Theodemo/clavier_midi/Rapport_VCO.pdf

# Rapport de projet

## Électronique Analogique

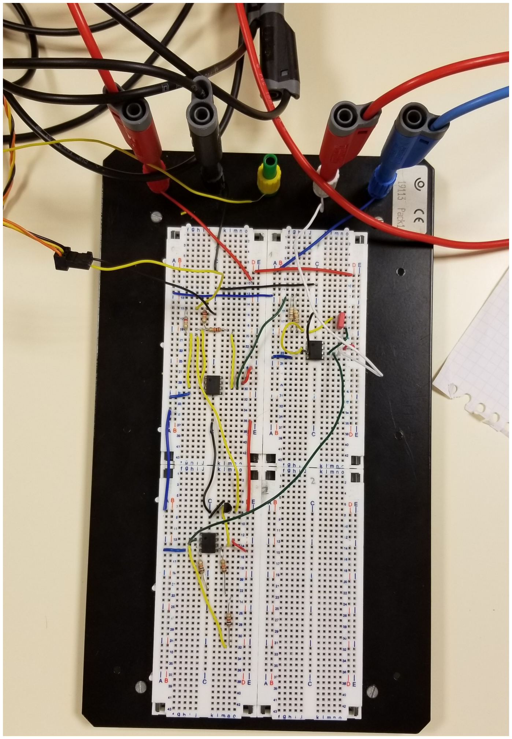
[picture p25: figure]

Théo de Morais & Maël CREAC’H – S1A A - 2020

## Table des matières

## Les résultats obtenus par simulation :

AOP numéro 1

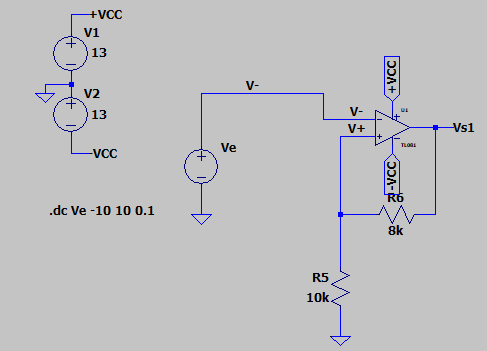
[picture p26: figure]

Nos expressions sont :
V
= Vs3

V

+ =

R5∗VS 1
R5+R6

Détermination des seuils :

VS 1=VSAT + quand VS 3<

R5∗V S1
R5+R6

VS 1=VSAT - quand VS 3>

R5∗V S1
R5+R6

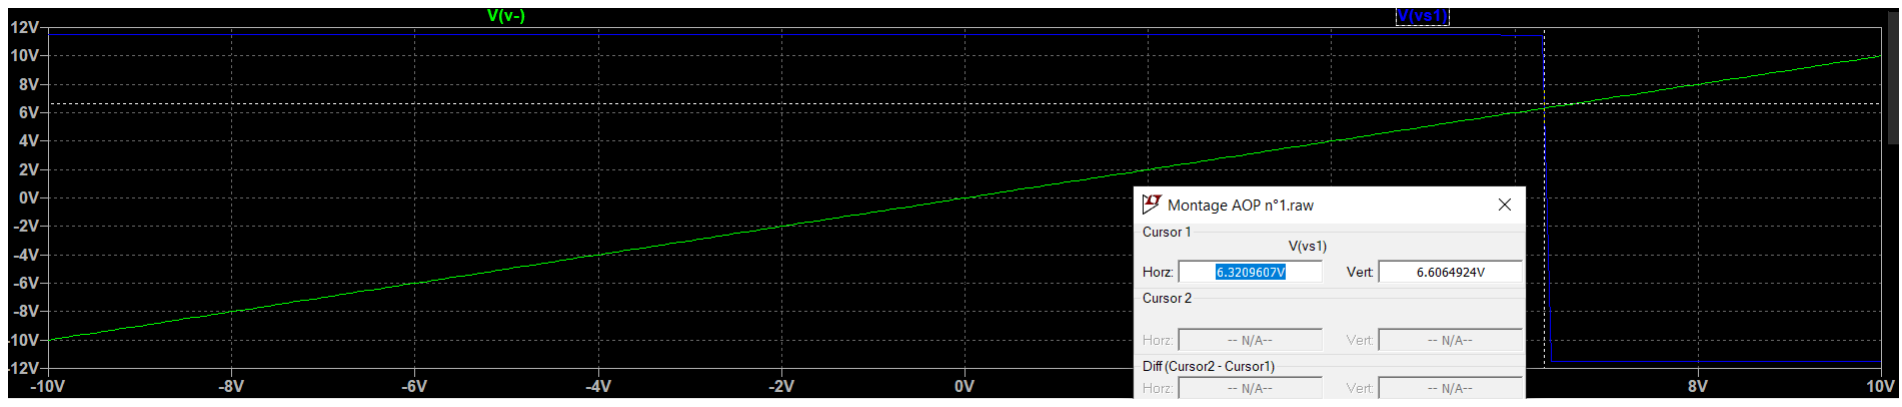
[picture p27: figure]

AOP numéro 2 (Vs1 = Vsat+)

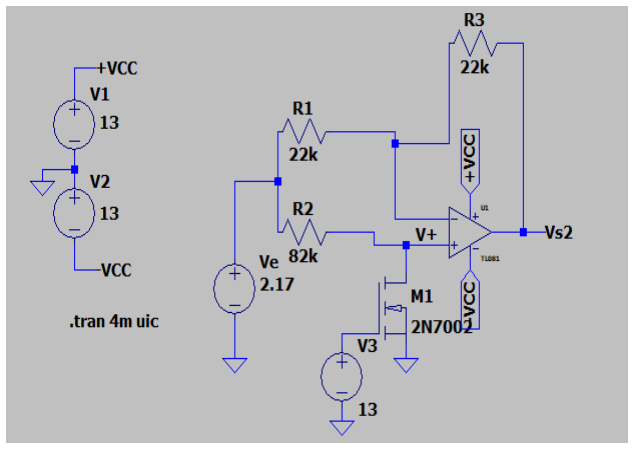
[picture p28: figure]

Équations de fonctionnement :

V -=

R2∗VVMC4+R1∗VS 2
R1+R2

V +=0

Vmc4=

−R1∗V S 2
R2

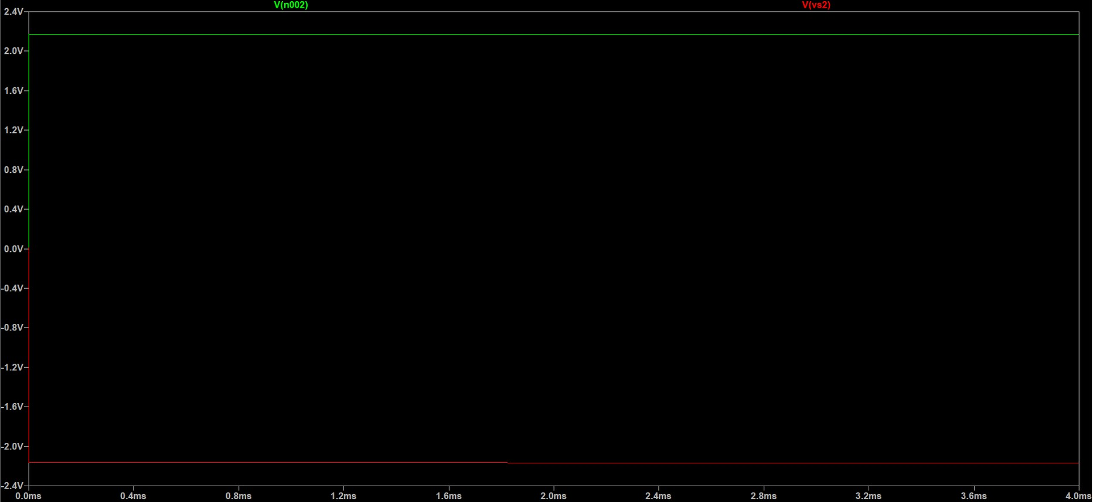
[picture p29: figure]

AOP numéro 2 (Vs1 = Vsat-)

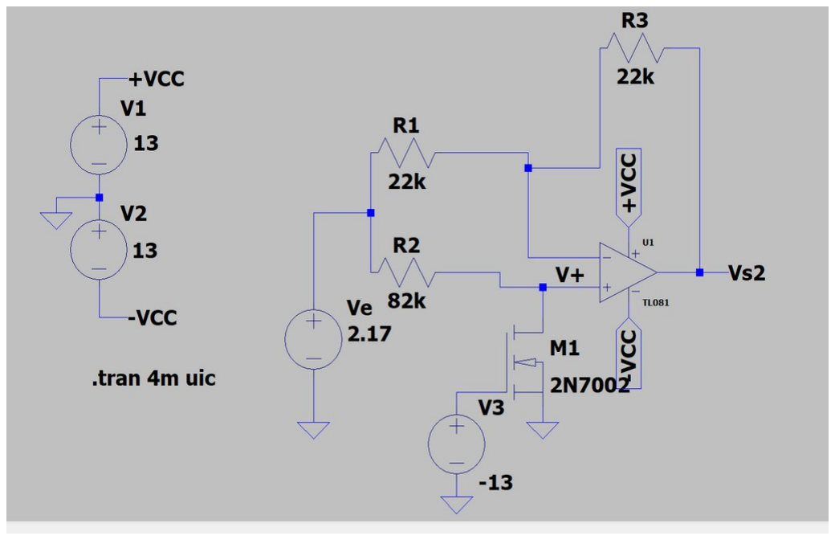
[picture p30: figure]

Équations de fonctionnement : V +=VMC

V -=

R2∗VVMC4+R1∗VS 2
R1+R2

VMC=VS 2

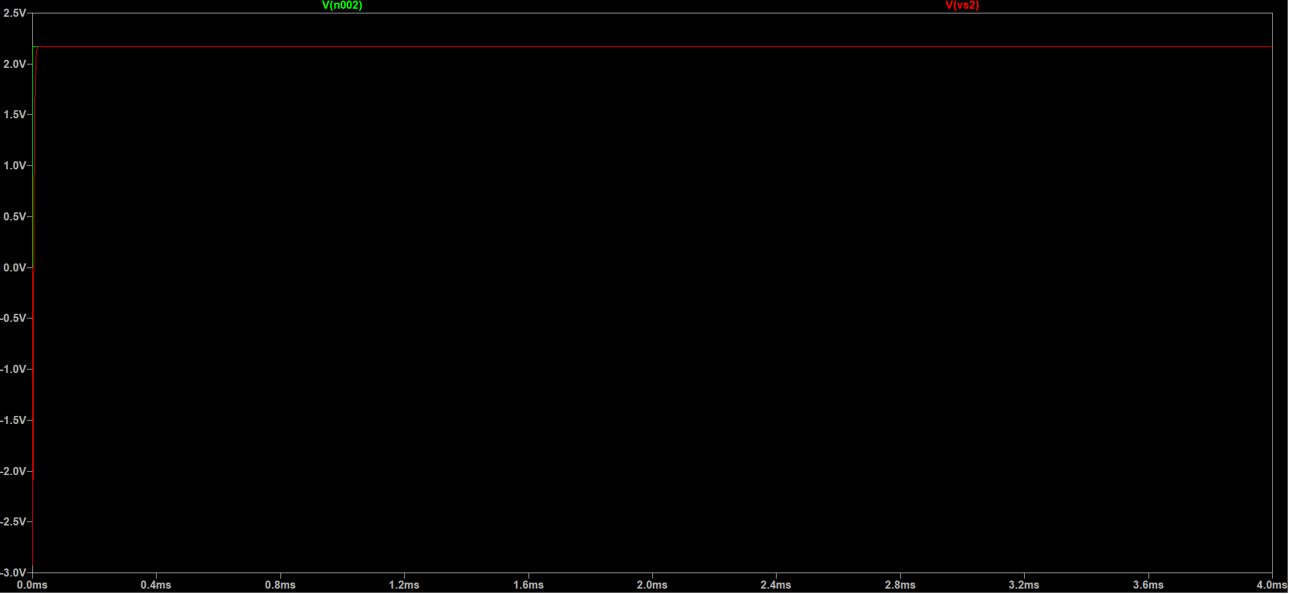
[picture p31: figure]

AOP numéro 3

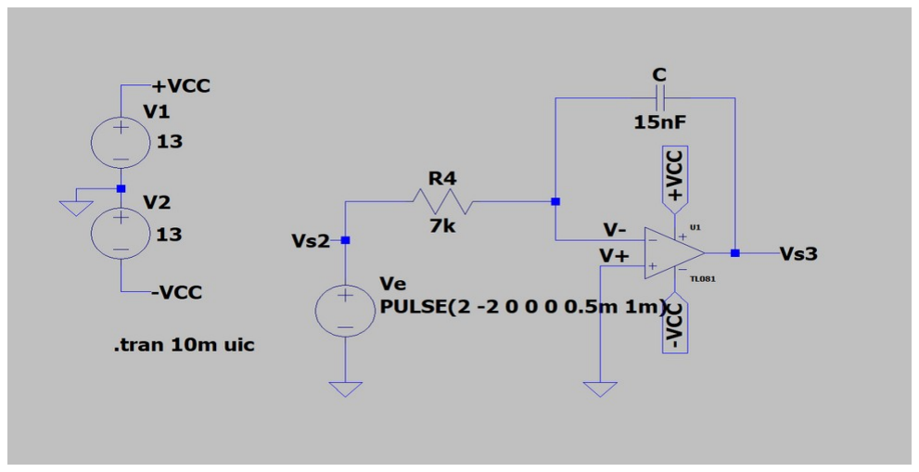
[picture p32: figure]

Équations de fonctionnement :

i(t)=

Ve
R 4

Vc(t)=

Ve∗t
R 4∗C

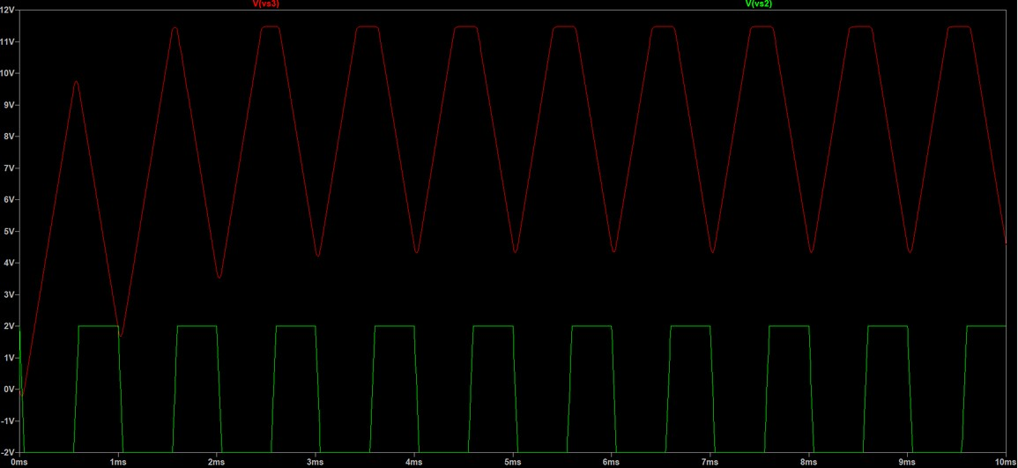
[picture p33: figure]

## Analyse du fonctionnement global du montage :

Nous avons décomposé le schéma complet en blocs afin d’expliquer le fonctionnement de chacun d’entre eux.
L’AOP n°1 est un comparateur à double seuil, qui va récupérer un signal triangle en Vs3 pour renvoyer un signal carré en Vs1 qui va varié entre Vsat + et Vsat –. La tension que renvoi le transitor est égale à 0V quand Vs1 = Vsat +, et lorsque Vs1 = Vsat-, la tension aux bornes du transitor est égale à V_MCV4.

L’AOP n°2 va permettre de transformer le signal continu V_MCV4 est un signal carré, d’amplitude V_MCV4.

L’AOP n°3 est un intégrateur qui va transformer le signal carré en VS2 en signal triangulaire.

Le rôle des résistances :
R1 et R2 permettent de régler l’amplitude de Vs2.
R4 permet d’agir sur la fréquence du signal Vs3. R6 et R5 permettent de régler l’amplitude de Vs3.

## Caractéristiques expérimentales :

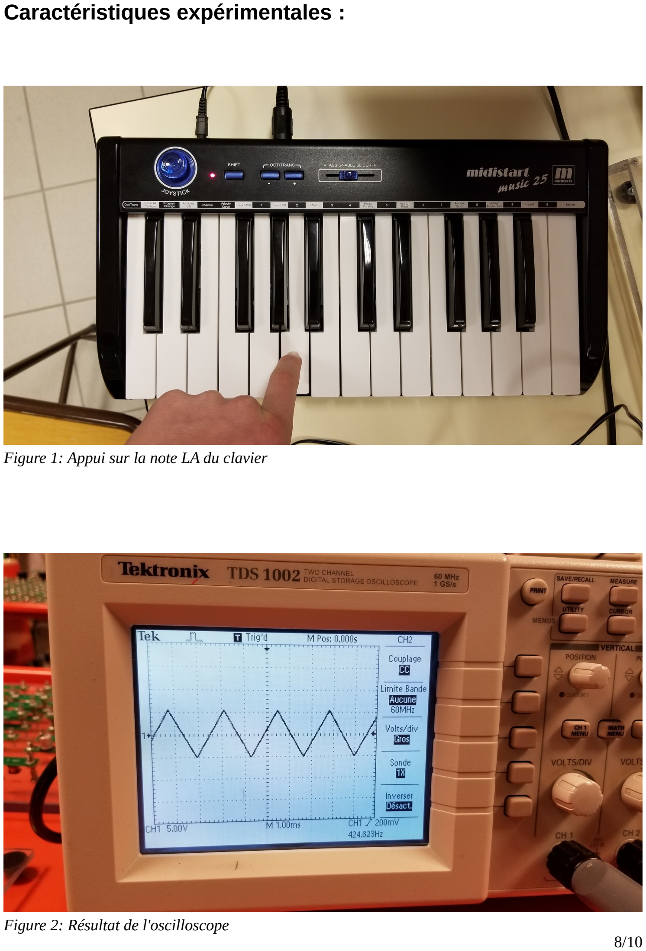
[picture p34: page 8]

Figure 2: Résultat de l'oscilloscope

Figure 1: Appui sur la note LA du clavier

## Photo du montage :

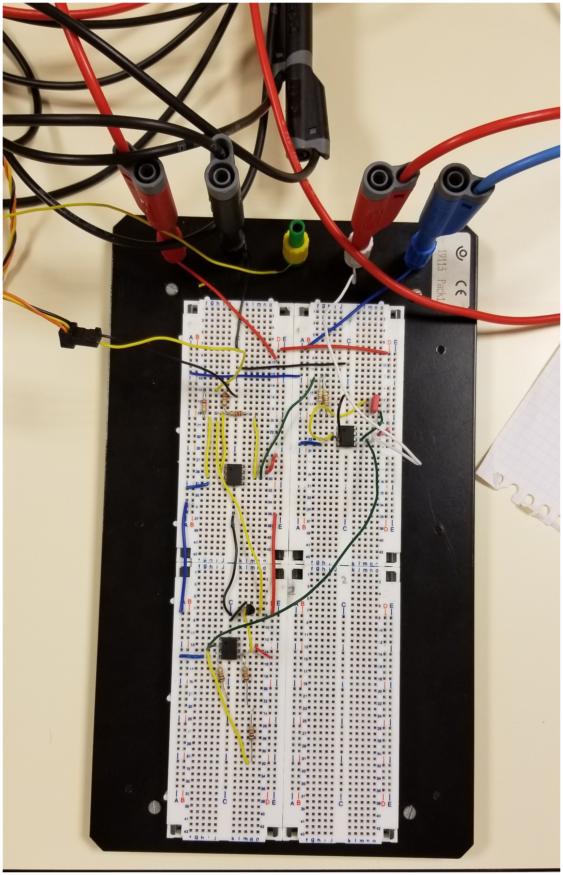
[picture p35: figure]

Figure 3 : Cablage opérationnel du projet

## Le tableur :

Le tableur comporte plusieurs feuilles comportant chaque une les enseignements suivants : La fréquence en fonction de la tension, le calcul des résistances et la répartition des taches. Le tableur est disponible sur le lien (https://docs.google.com/spreadsheets/d/1JsvgY41jIkuGvzgermUx4HYxyJ-hoyll8IgTpZJOuaQ/edit?usp=sharing) suivant : https://bit.ly/374Cc81

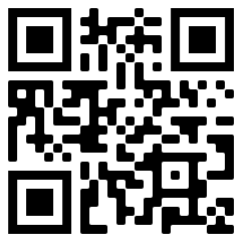
[picture p36: figure]
