Theodemo/clavier_midi/Tableur_VCO.ods

Sheet: Frequence et tension
 |  | Fréquence de sortie
Note jouée au clavier | Fréquence | V/oct | V/Hz
Do | 262 | 1.01 | 0.59
Do# | 278 | 1.10 | 0.61
Ré | 294 | 1.18 | 0.654
Ré# | 312 | 1.26 | 0.71
Mi | 330 | 1.34 | 0.75
Fa | 350 | 1.43 | 0.79
FA# | 370 | 1.50 | 0.83
Sol | 392 | 1.58 | 0.88
Sol# | 415 | 1.67 | 0.92
La | 440 | 1.75 | 0.98
La# | 465.99999996 | 1.83 | 1.03 | Coef de corélation | 0.9847262637
Si | 494 | 1.91 | 1.10
Do( octave 2) | 523 | 2.00 | 1.16
Do# | 554 | 2.09 | 1.20
Ré | 586 | 2.16 | 1.29
Ré# | 621 | 2.25 | 1.36
Mi | 658 | 2.33 | 1.47
Fa | 696 | 2.42 | 1.54
FA# | 738 | 2.49 | 1.63
Sol | 781 | 2.57 | 1.72
Sol# | 827 | 2.65 | 1.79
La | 876 | 2.74 | 1.93
La# | 928 | 2.82 | 2.05
Si | 983 | 2.90 | 2.11 | 471.796524727518 | -21.3621271329204
DO | 1041 | 2.98 | 2.17 | f(x) = | 471,7965247x -21,36212711
 |  |  |  | Coef de corélation | 0.9988611129

Sheet: Calcul des resistances
Tableur du calcul des résistances |  |  |  |  |  |  | Utiliser le point du pavé numérique !!!!
Valeurs fixées par le cahier des charges |  |  | Valeurs fixées arbitrairement |  |  | Valeurs fixées pour vérifier le cahier des charges et fonction des caractérisiques du MCV4
Composant | Valeur | Unité | Composant | Valeur | Unité | Element | Valeur | Unité
R3 | 83 | kOhms | R1 | 22 | kOhms | V_MCV4 | 2.166 | V
C | 15 | nFarad | R5 | 10 | kOhms | Fréquence | 1041 | Hz
Vsat+ | 13 | Volts |  |  |  | Vseuil1 | 5 | V
Vsat- | -13 | Volts |  |  |  | Vseuil2 | -5 | V
 |  |  |  |  |  | Vs1 | 13 | V
 |  |  |  |  |  | Vs1 (avec tensiond dechets) | 11.47 | V
 |  |  |  |  |  | Amplitude Vs3 | 5 | V
 |  |  | Resultats
 |  |  | Composants | Valeure | Unité
 |  |  | R2 | 22 | kOhms
 |  |  | R4 | 6.9 | kOhms
 |  |  | R6 | 16 | kOhms
 |  |  | R6 (tensions dechets) | 12.9 | kOhms

Sheet: Repartition des taches
 |  |  | Maël CREAC'H |  | Théo DE MORAIS
 |  |  |  | Maël et Théo
Liste des taches | Date des cours TP | 06/11/2020 | 13/11/2020 | 20/11/2020 | 27/11/2020 | 04/12/2020 | 11/12/2020
Découverte du projet | x | MT
Création du tableur | x | MT
Etude AOP 1 | x |  | MT
Etude AOP 2 | x |  |  | MT
Cablage AOP1 | x |  |  |  | MT | T
Etude AOP 3 | x |  |  |  | MT | M
Création du tableur 2 | x |  |  |  | M | M
Cablage AOP 2 | x |  |  |  | T | MT
Cablage AOP 3 | x |  |  |  |  |  | T
Rédaction du rapport | x |  |  |  |  |  | M
Cablage total | x |  |  |  |  |  | MT
