Theodemo/clavier_midi/dossier_simulation_ADSR/ADSR_S2P_2021_Final.asc

C1: cap; 10n
C2: cap; 10µ
C3: cap; 15n
C4: cap; 0.33µ
C5: cap; 0.10µ
Cout: cap; 470n
D1: diode
D2: diode
D3: diode; 1N4148
M1: nmos; 2N7002
R1: res; 248226
R2: res; 377791
R3: res; 25k
R4: res; 139322
R5: res; 60k
R6: res; 2.2k
R7: res; 5k
R8: res; 26k
R9: res; 6948
R10: res; 22k
R11: res; 22k
R12: res; 82k
R13: res; 10k
R14: res; 12953
R15: res; 10k
R16: res; 25531914
R: res; 100k
U1: 74hct04
U2: 74hct123
U3: 74hct138
U4: CD4066
U5: 74hct04
U6: CD4066
U7: CD4066
U8: 74hct04
U9: 74hct04
U10: CD4066
U11: 7805
U12: TL081
U13: TL081
U14: TL081
U15: AD633
U16: TL081
U17: TL081
V1: voltage; 15
V2: voltage; -15
V3: voltage; PWL(0 0 0.1 0 0.10000001 12 1.2 12 1.20000001 0 1.79999999 0 1.8 12 1.8999999 12 1.9 0 1.91 0 1.9111111 12); Rser=50
V4: voltage; 0.87
Named nets: 0, V_CV1, V_GATE, VB, VA, CTRL0, CTRL2, VDD, CTRL1, CTRL3, VCC, VSS, Vcc, Vimp, vA, Vtriangle, V+, V-, Vs1, Vs2, Vdd, Vs, VSON, Rx/Vx
.tran 0 1.6 0 100U uic
Generateur d'Enveloppe ADSR
Automne 2020
SIGNAUX MCV4
SPICE DIRECTIVES et SIMULATION
.ic V(C1) = 0
.ic V(Cout)=0
.inc 74hct_ENIB.lib
 
.inc CD4066.lib
adaptations : schéma à tester dans
 un fichier .asc à part puis à recopier ici
monostable déclenchement front montant
1seule des 2 structures intégrées 
dans le composant est représentée
décodeur 3 bits et portes NON
switchs commandés
Couples Vx, Rx à raccrocher
indépendamment
sur chaque entrées
alimentations
composants à rajouter autour : 
R1et C1
le RIT est  simulé par le composant ci dessous
Un élément est à rajouter pour garantir 
la stabilitéde la tension de sortie
face aux appels de courants
.inc Vreg.lib
éventuellement diode particulière
(voir doc)
.inc AD633.lib
