Theodemo/clavier_midi/dossier_simulation_ADSR/Draft1.asc

D1: diode
R1: res; 1k
V1: voltage; SINE(0 2 1k)
Named nets: 0, Vs, Ve
.tran 2ms
