Theodemo/clavier_midi/dossier_simulation_VCO/Ensemble_VCO.asc

C: cap; 15n
M1: nmos; 2N7002
R1: res; 22k
R2: res; 22k
R3: res; 82k
R4: res; 6948
R5: res; 10k
R6: res; 12953
U1: TL081
U2: TL081
U3: TL081
V1: voltage; 13
V2: voltage; 13
V_MCV4: voltage; 2.17
Named nets: 0, Vs3, +VCC, -VCC, V+, V-, Vs1, Vs2
.tran 5m uic
